trnkaja5/Meteostanice/README.md

# Meteostanice
Maturitni projekt

Cílem této práce je navrhnout a zkonstruovat
meteostanici s venkovní a vnitřní
jednotkou, která měří základní meteorologická
data a zpracovává je ve vnitřní
jednotce. Data se budou zapisovat na
microSD a zobrazovat na displeji a webserveru.
