trnkaja5/Meteostanice/elektro/dokumentace_DPS.pdf

Dokumentace DPS - Meteostanice | Jan Trnka 4EB
- Návrh všech plošných spojů jsem realizoval v programu KiCad 7.0.

## Vnitřní jednotka:

### Schéma:

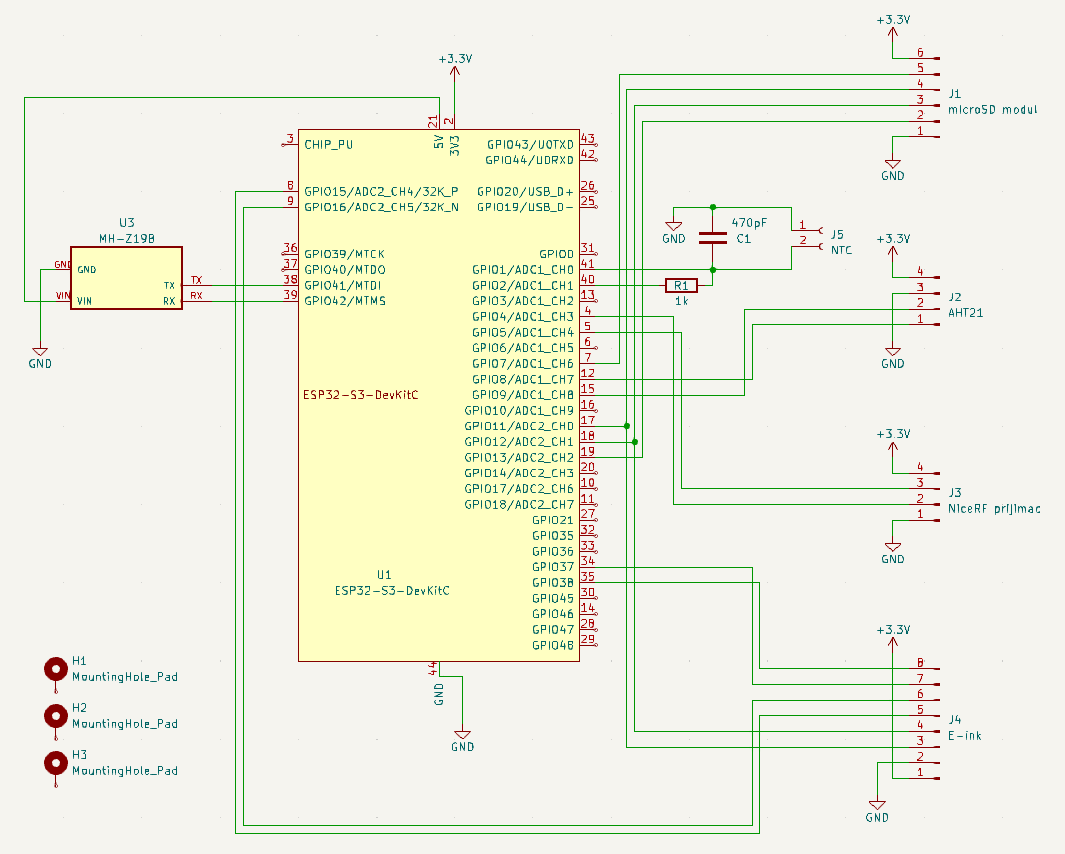
[picture p30: figure]

### Board:

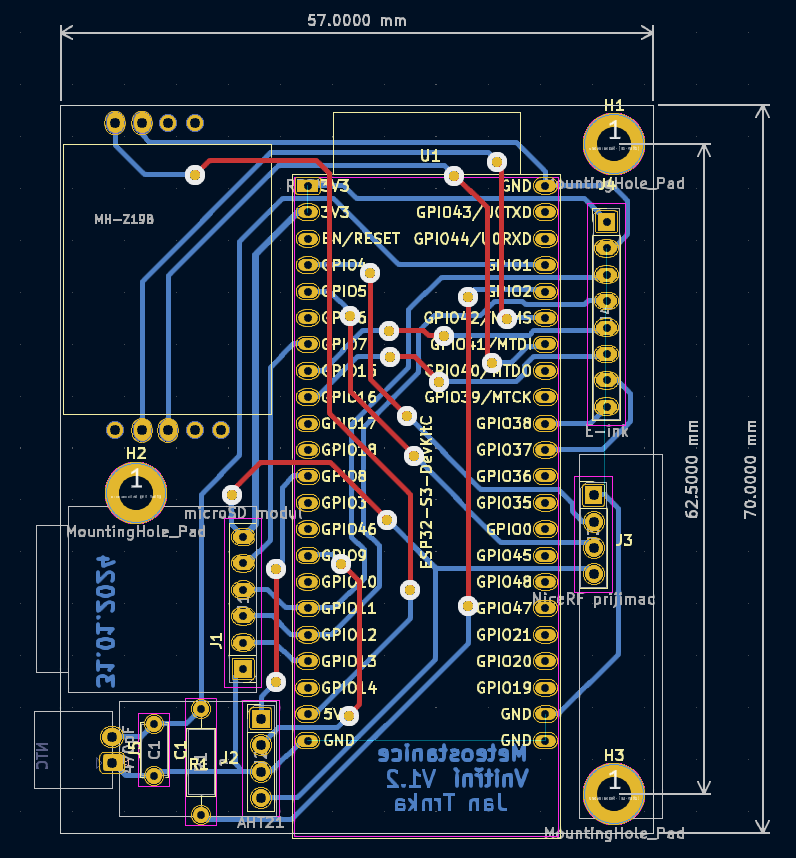
[picture p31: figure]

### Soubory pro leptání:

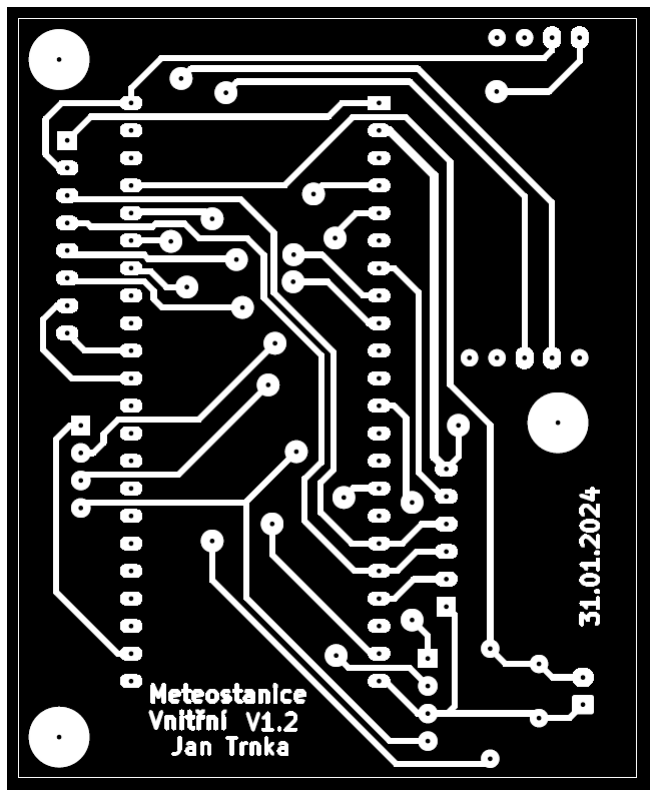
[picture p32: figure]

### Seznam součástek:

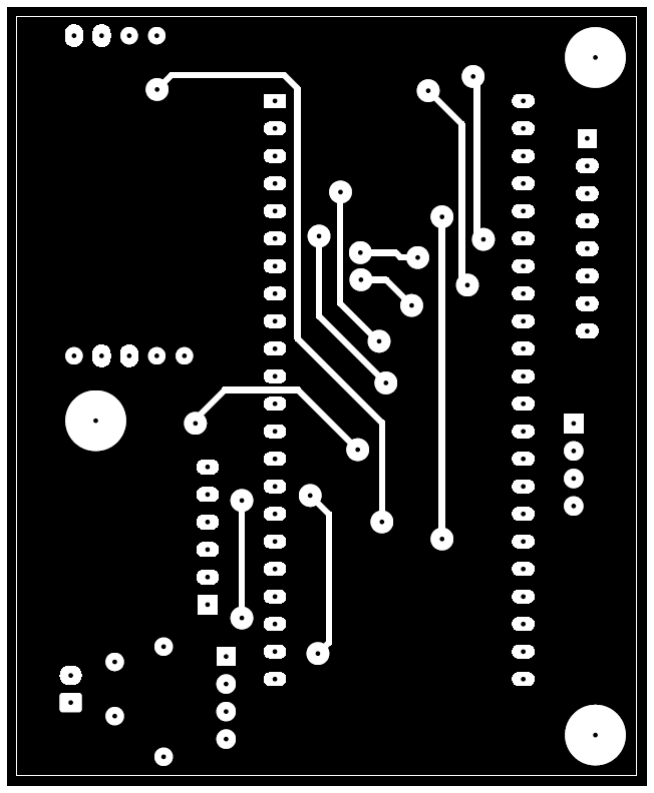
[picture p33: figure]

Esp32s3 DevKit | U1
MH-Z19B | U2
Konektor k NTC | J5
Kondenzátor 470pF | C1
Rezistor k NTC | R1
microSD modul | J1
AHT21 | J2
Rádiový přijímač | J3
Displej | J4
Bottom | Front

## Venkovní jednotka:

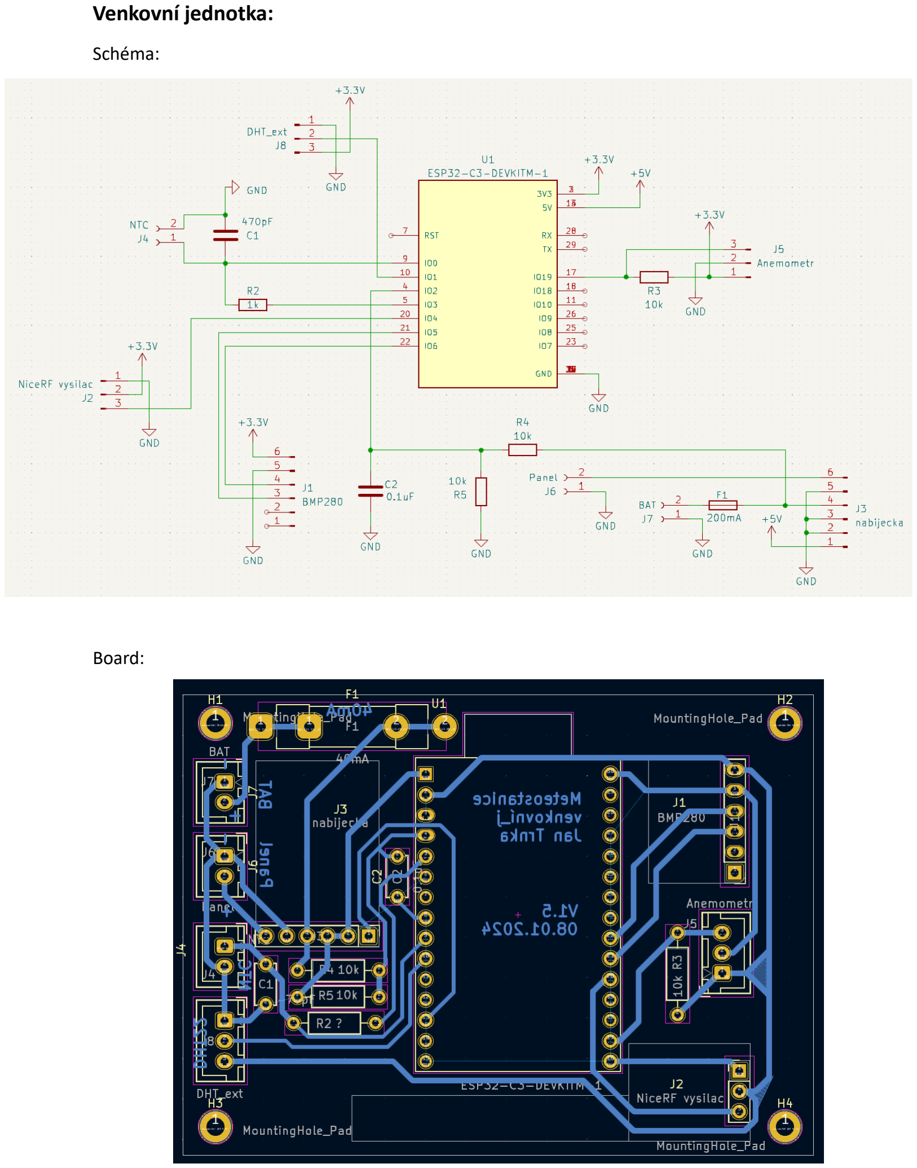
[picture p34: page 4]

### Schéma:

### Board:

### Soubor pro leptání:

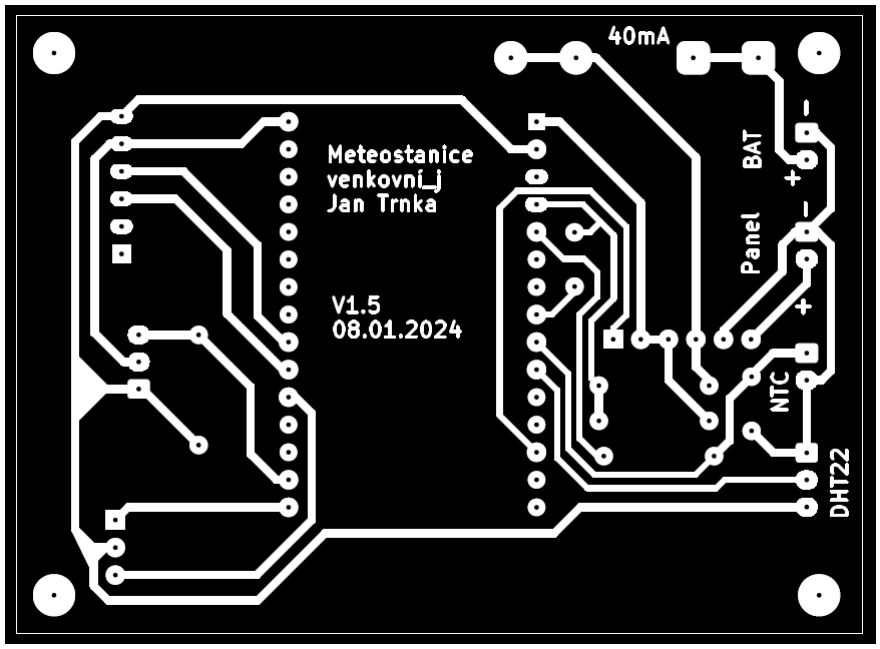
[picture p35: figure]

### Seznam součástek:

Esp32c3 DevKit | U1
DHT22 | U2
BMP280 | J1
Rádiový vysílač | J2
Solární nabíječka | J3
Konektor k NTC | J4
Kondenzátor 470pF | C1
Rezistor k DHT22 – 1kΩ | R1
Rezistor k NTC | R2
Pojistka trubičková 200 mA | F1

Bottom

## DPS pro senzor DHT22:

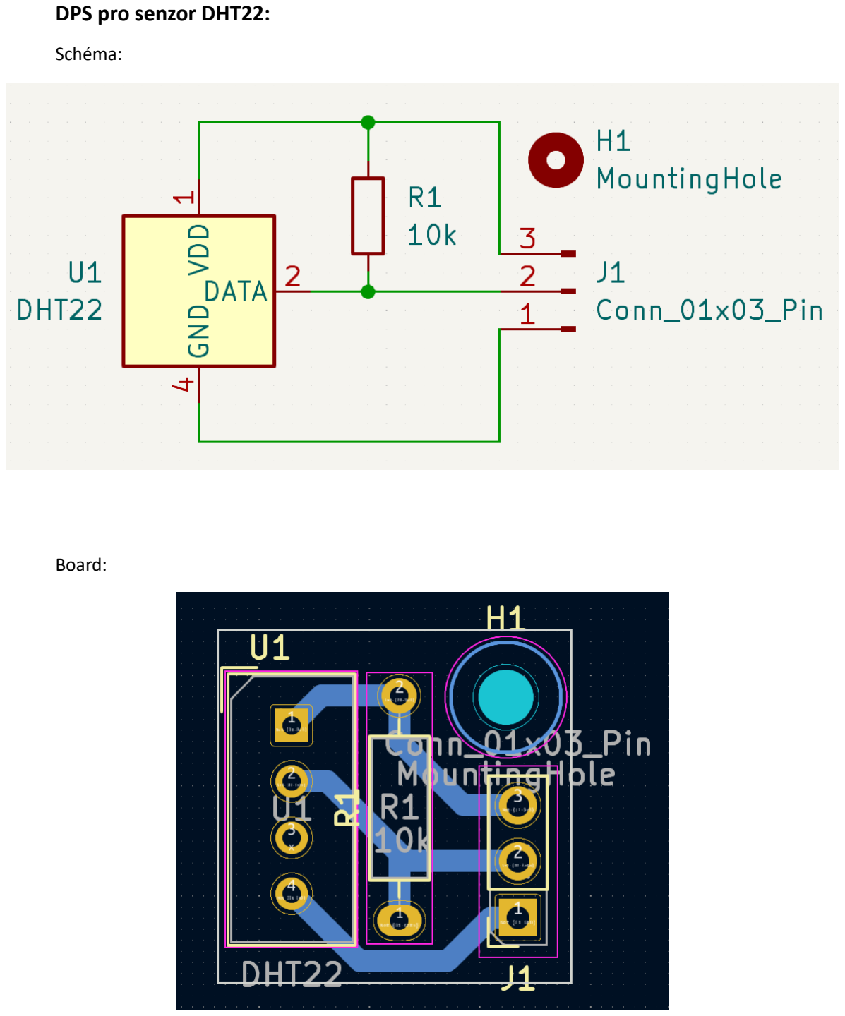
[picture p36: page 6]

### Schéma:

### Board:

### Soubor pro leptání:

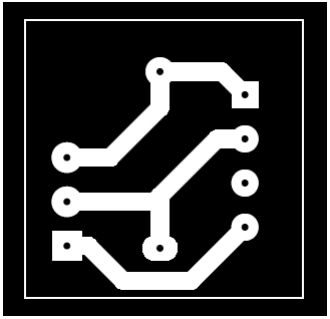
[picture p37: figure]

### Seznam součástek:

DHT22 | U1
Rezistor 1kΩ | R1

## Funkčnost:

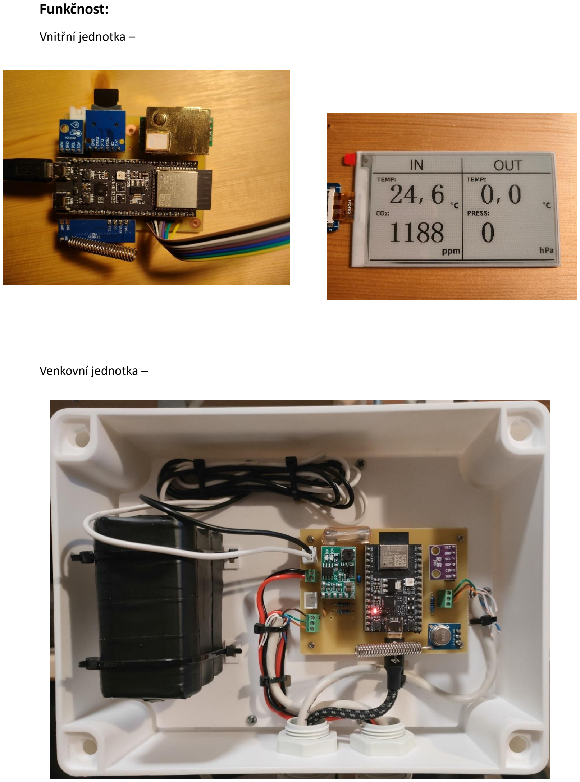
[picture p38: page 8]

### Vnitřní jednotka –

### Venkovní jednotka –

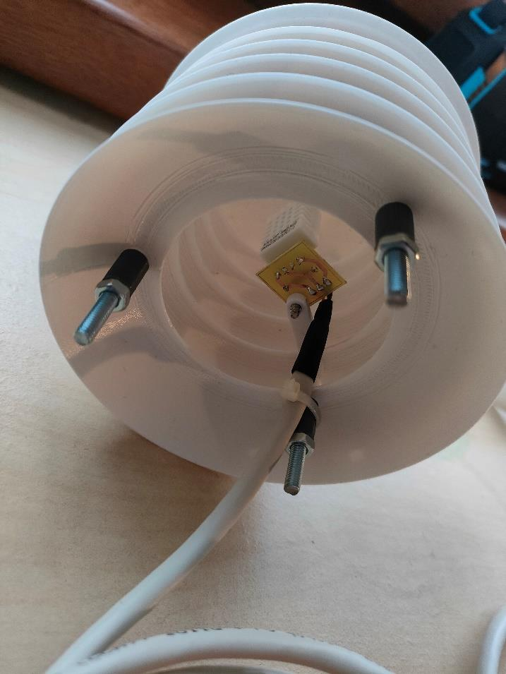
[picture p39: figure]

### DHT22:

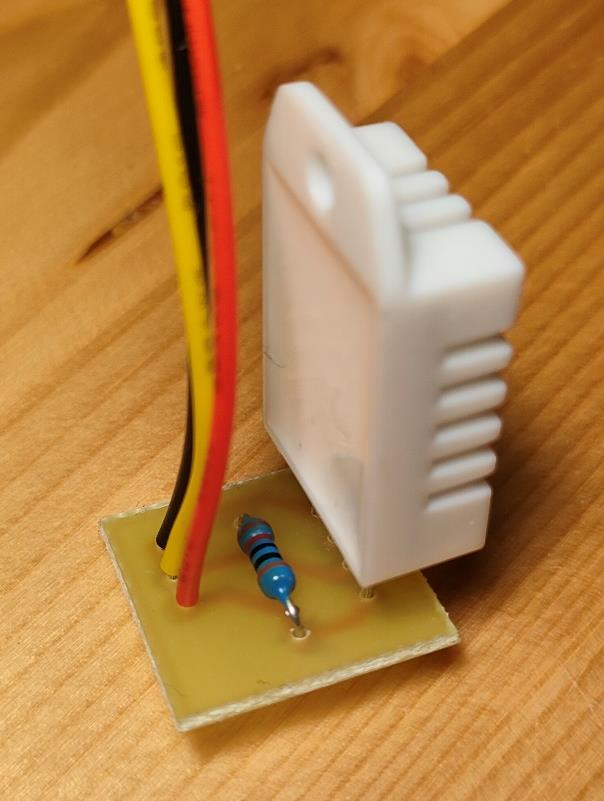
[picture p40: figure]
