trnkaja5/Meteostanice/elektro/schema_zapojeni_venkovni_jednotka.png

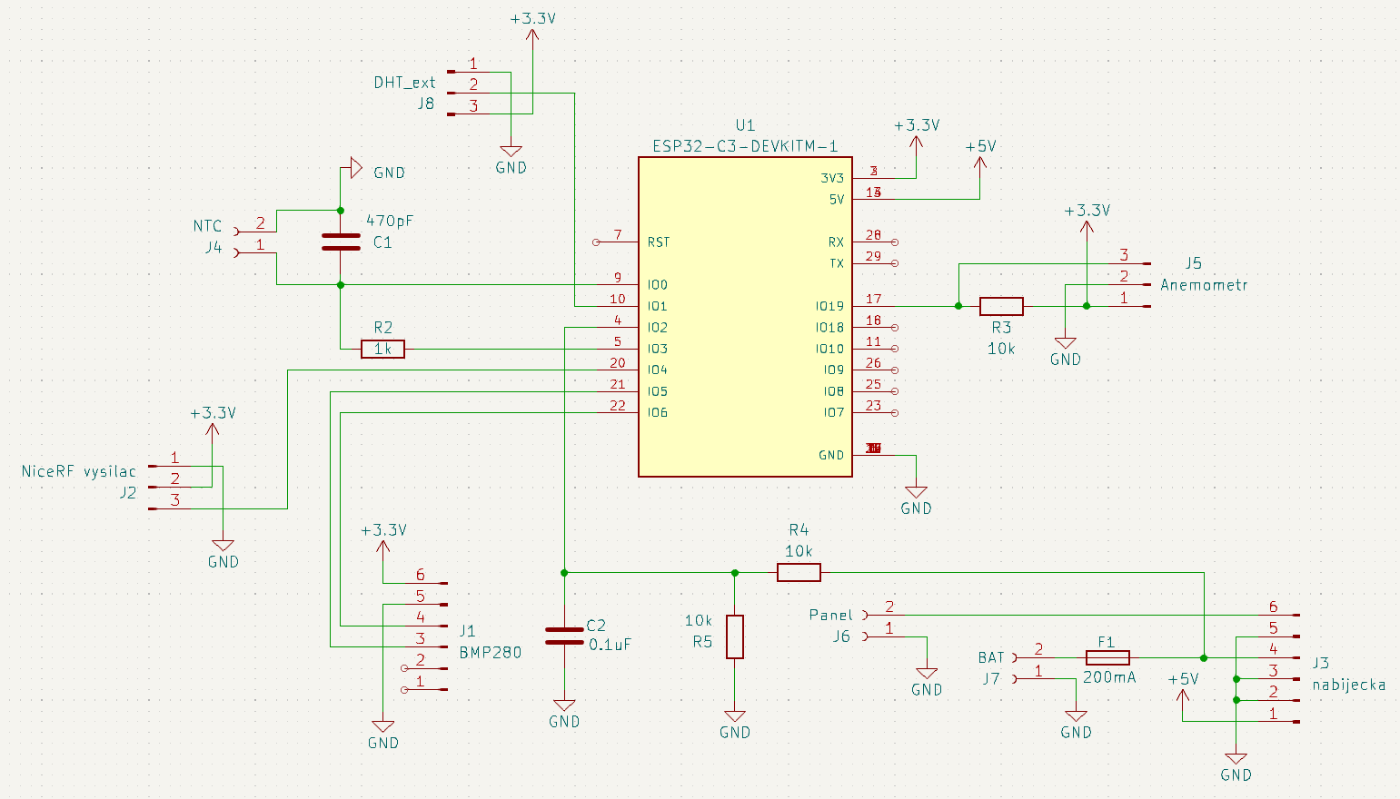
elektro/schema_zapojeni_venkovni_jednotka.png
