trnkaja5/Meteostanice/media/foto_venkovni_jednotka.jpg

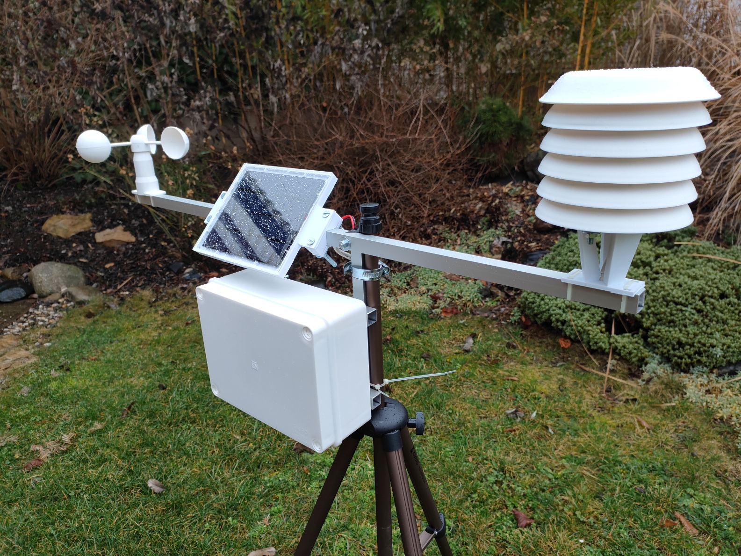
media/foto_venkovni_jednotka.jpg
