trnkaja5/Meteostanice/media/foto_vnitrni_jednotka.jpg

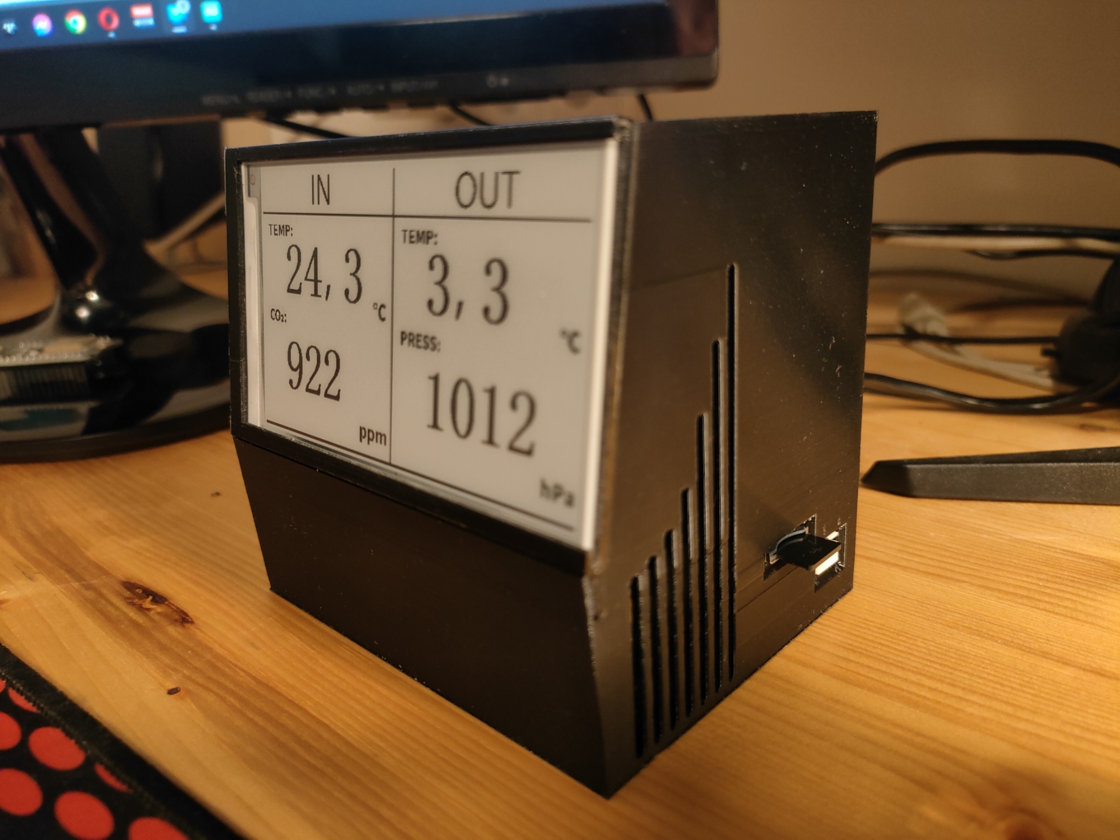
media/foto_vnitrni_jednotka.jpg
