trnkaja5/Meteostanice/media/foto_zapojeni_venkovni.jpg

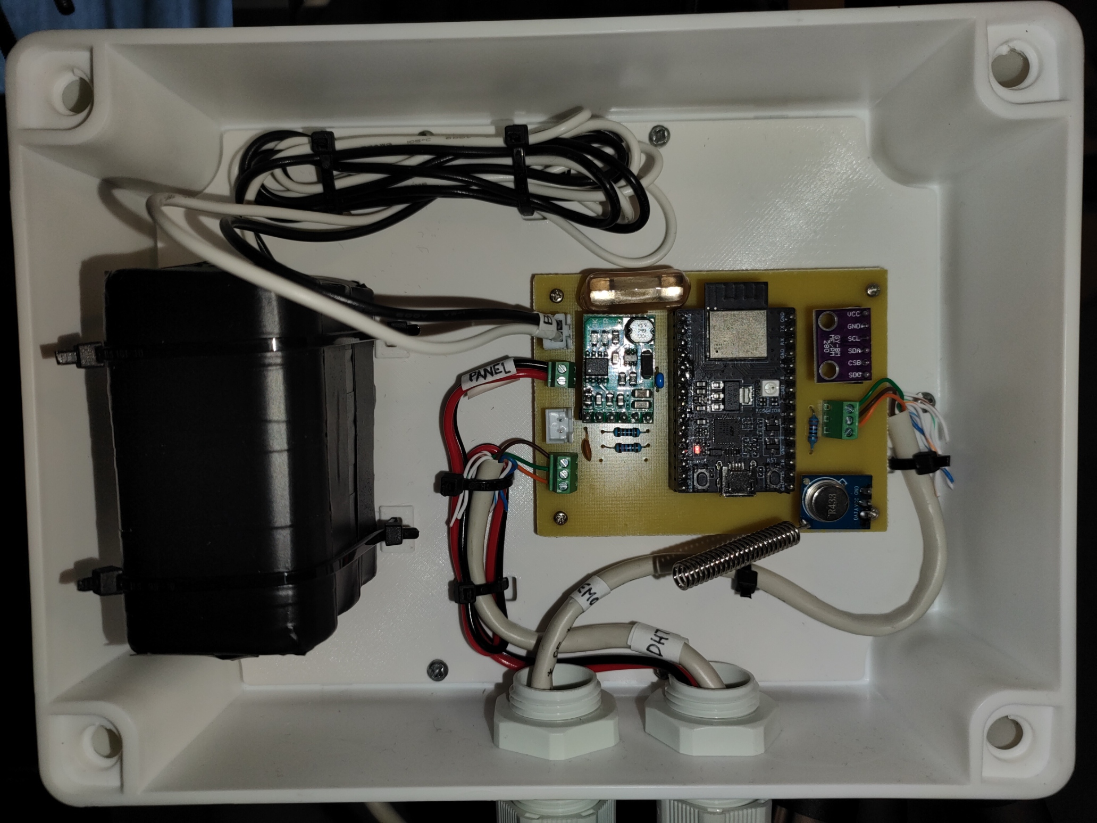
media/foto_zapojeni_venkovni.jpg
