trnkaja5/Meteostanice/media/foto_zapojeni_vnitrni.jpg

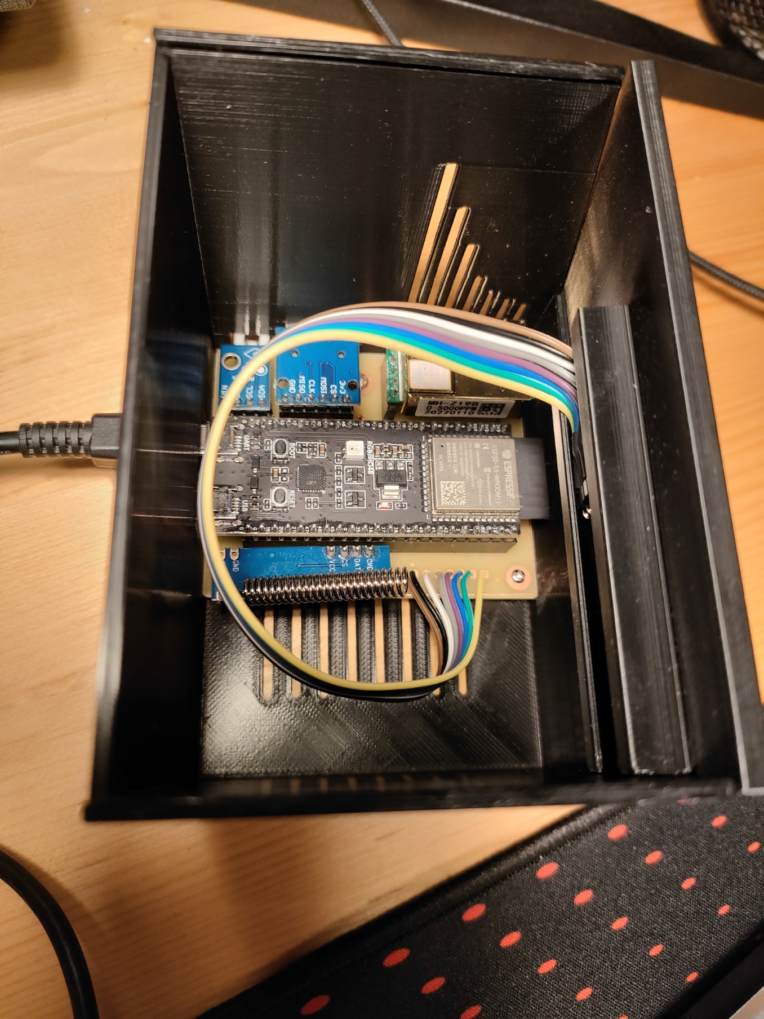
media/foto_zapojeni_vnitrni.jpg
