trnkaja5/Meteostanice/media/screenshot_webserver.png

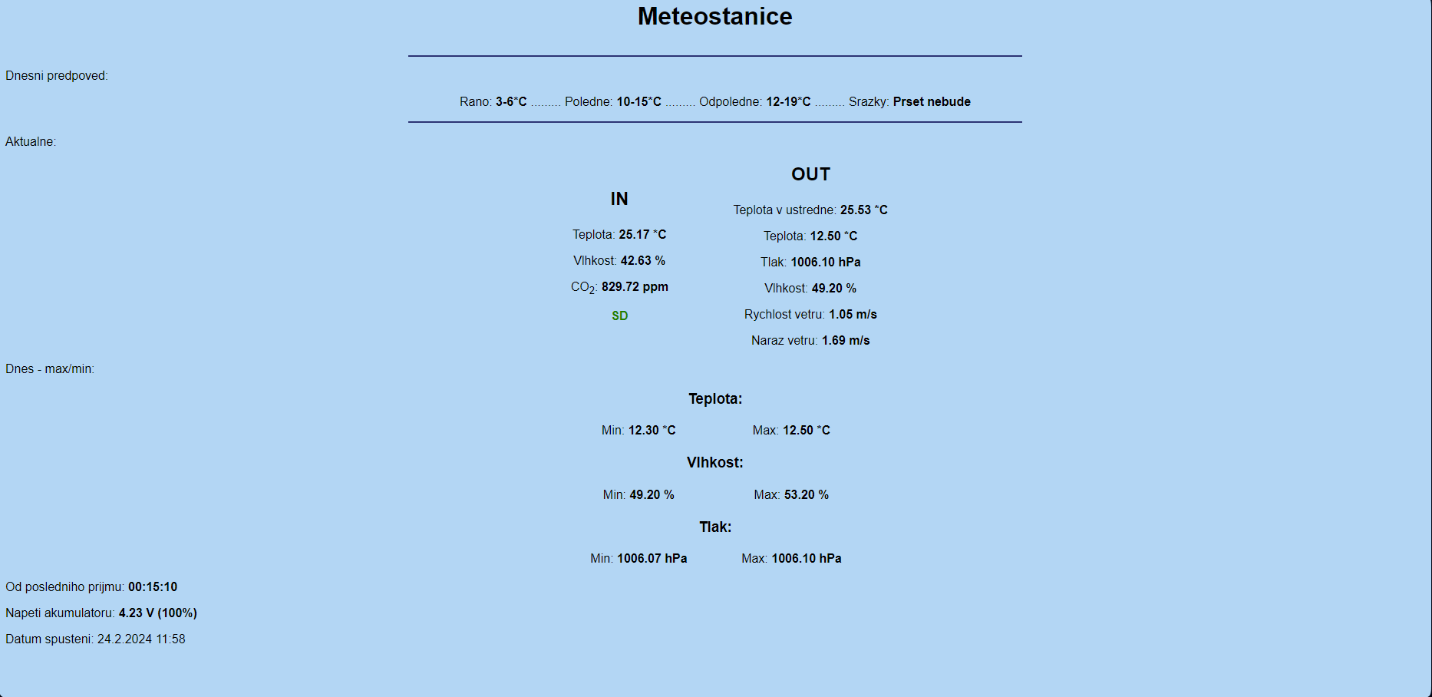
media/screenshot_webserver.png
