trnkaja5/Meteostanice/meteostanice_plakat.jpg

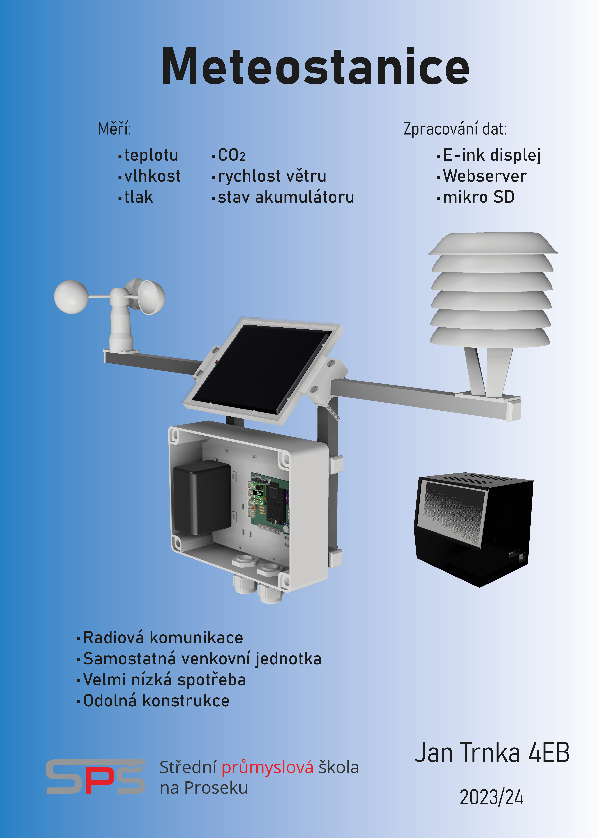
meteostanice_plakat.jpg
