trnkaja5/Meteostanice/elektro/KiCad_modely/DHT22 v1.step

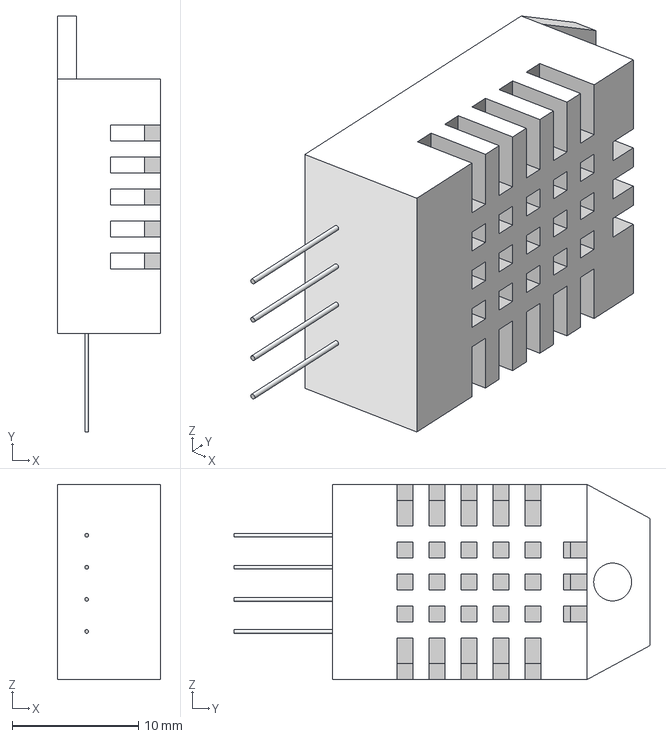
[picture p51: CAD file, 2024-11-08]
elektro/KiCad_modely/DHT22 v1.step
8.15 x 33.0 x 15.5 mm
