trnkaja5/Meteostanice/mechanika/modely/radiační kryt_uchyt v3.stl

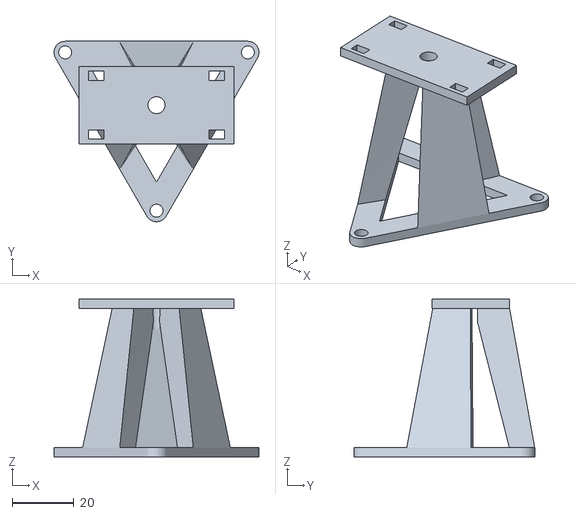
[picture p52: CAD file, 2024-11-08]
mechanika/modely/radiační kryt_uchyt v3.stl
66.2 x 58.3 x 51.0
