trnkaja5/Meteostanice/elektro/KiCad_modely/bmp280 v1.step

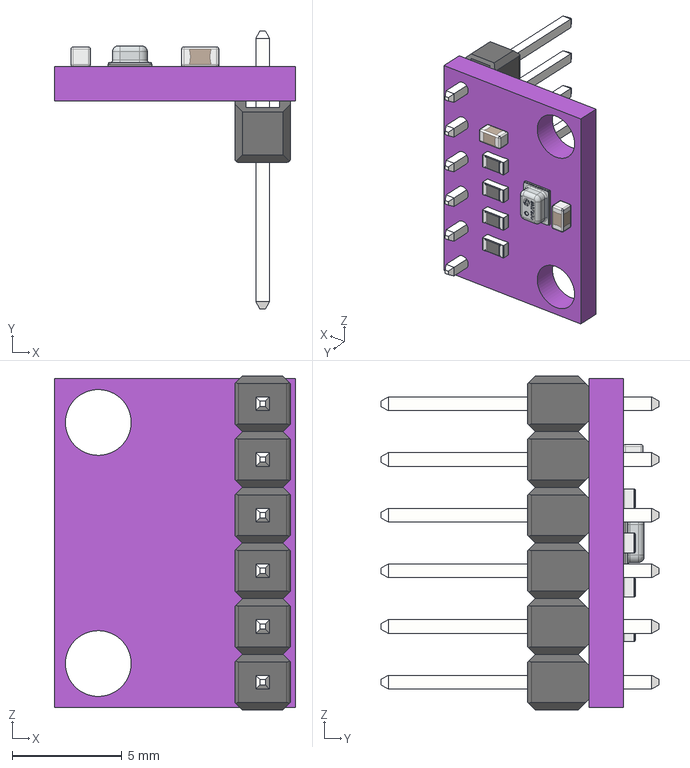
[picture p53: CAD file, 2024-11-08]
elektro/KiCad_modely/bmp280 v1.step
11.0 x 12.7 x 15.2 mm
