trnkaja5/Meteostanice/mechanika/modely/redukce do krabice v6.stl

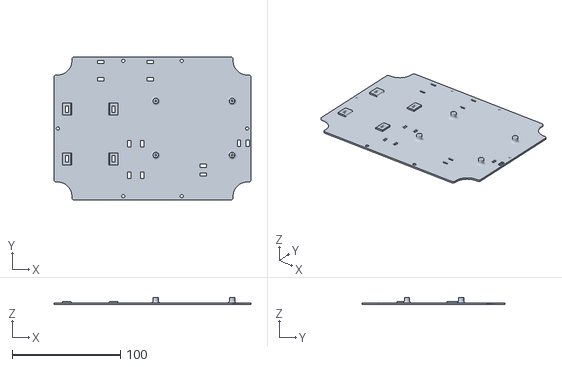
[picture p54: CAD file, 2024-11-08]
mechanika/modely/redukce do krabice v6.stl
182.0 x 132.0 x 6.50
