trnkaja5/Meteostanice/elektro/KiCad_modely/MH-Z19B v1.step

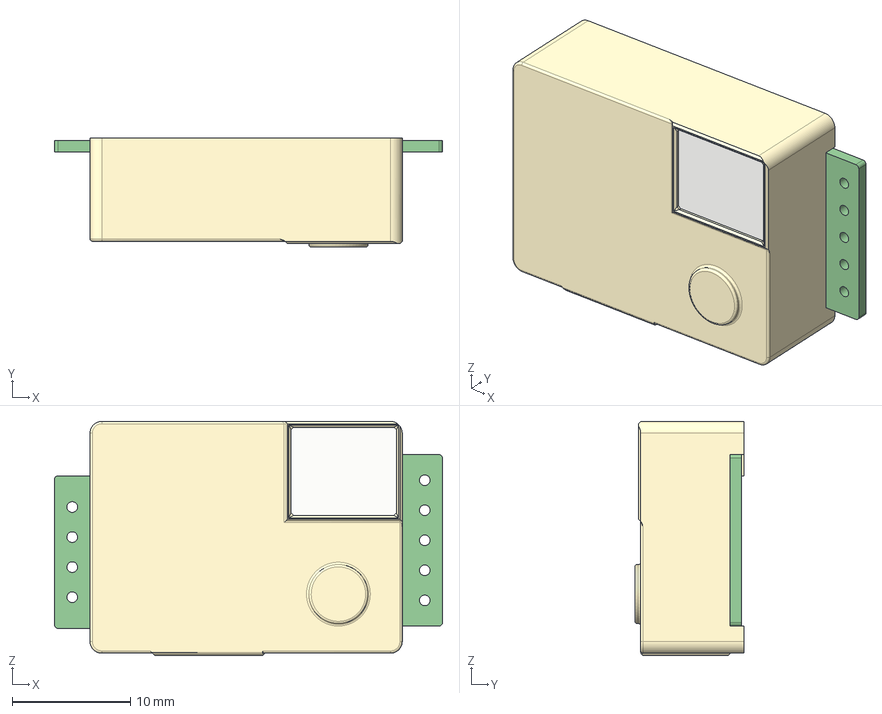
[picture p55: CAD file, 2024-11-08]
elektro/KiCad_modely/MH-Z19B v1.step
32.8 x 9.25 x 19.8 mm
