trnkaja5/Meteostanice/mechanika/modely/Sloupek(radiackniKryt) v3.stl

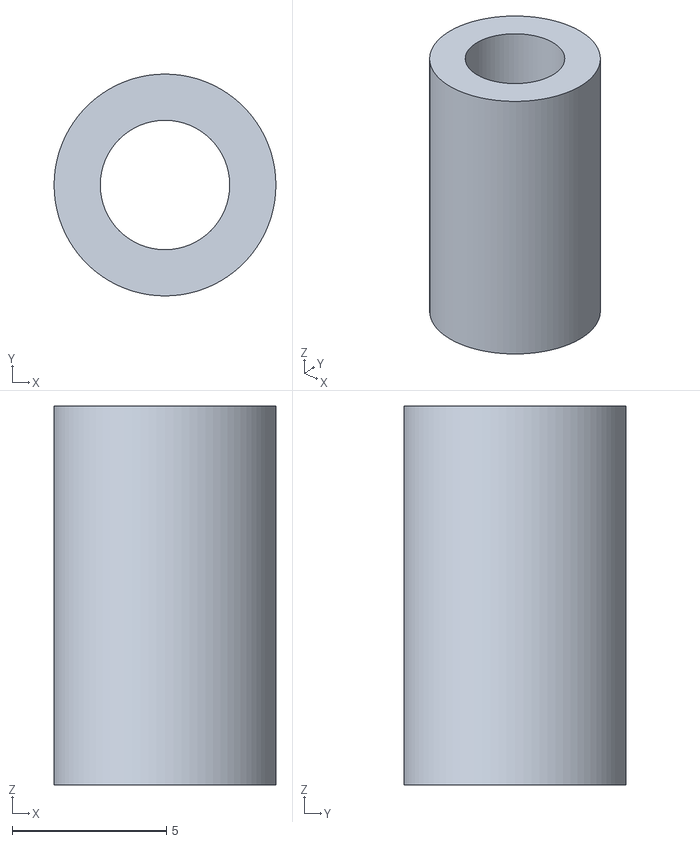
[picture p56: CAD file, 2024-11-08]
mechanika/modely/Sloupek(radiackniKryt) v3.stl
7.20 x 7.20 x 12.3
