trnkaja5/Meteostanice/elektro/KiCad_modely/POJISTKA v2.step

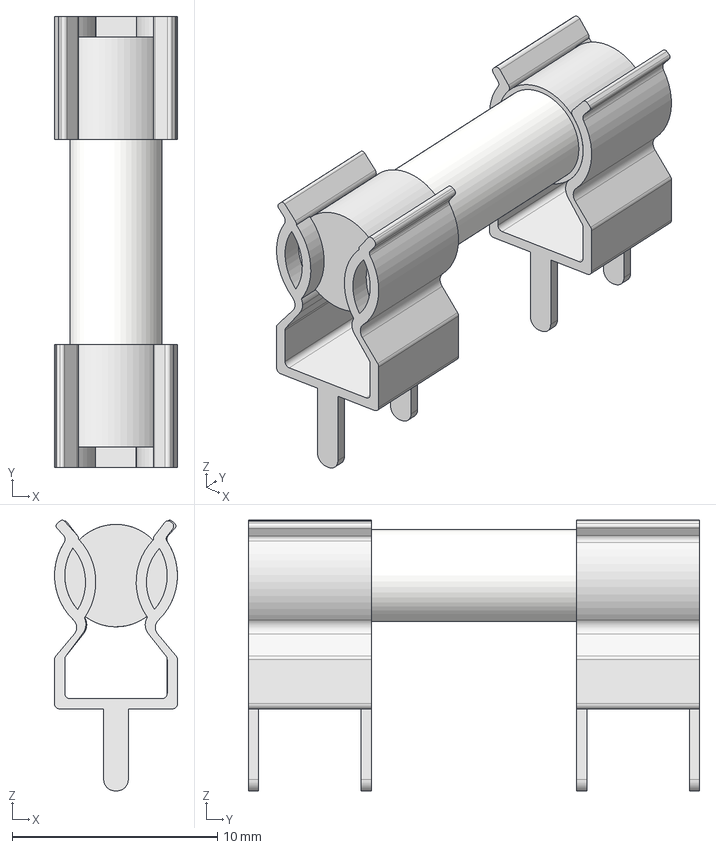
[picture p57: CAD file, 2024-11-08]
elektro/KiCad_modely/POJISTKA v2.step
6.00 x 22.0 x 13.2 mm
pojistka_1
drzak pojistky x 2
