trnkaja5/Meteostanice/mechanika/modely/krytka 15x15 v1.stl

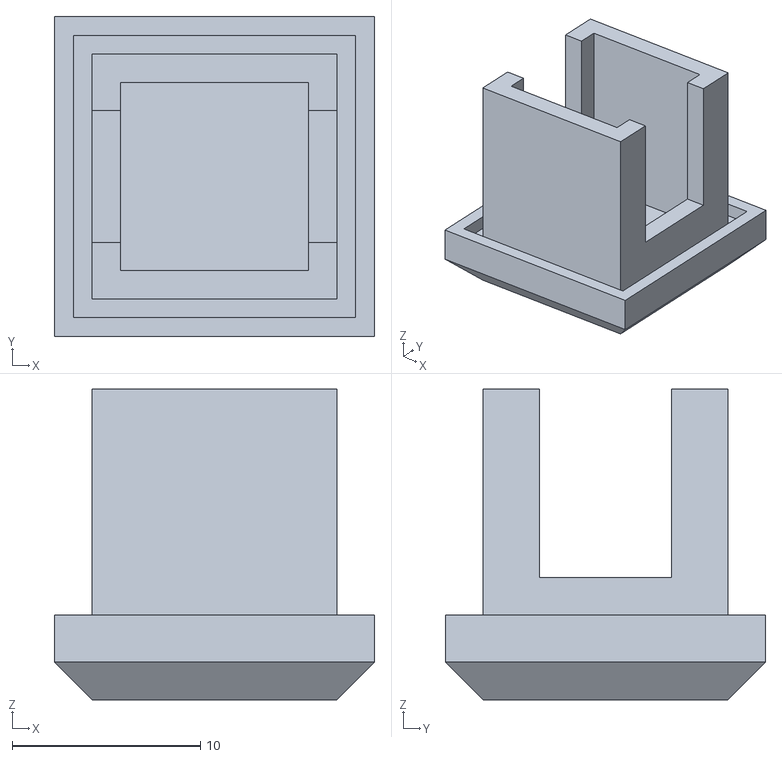
[picture p58: CAD file, 2024-11-08]
mechanika/modely/krytka 15x15 v1.stl
17.0 x 17.0 x 16.5
