trnkaja5/Meteostanice/elektro/KiCad_modely/solarni nabijecka v2.step

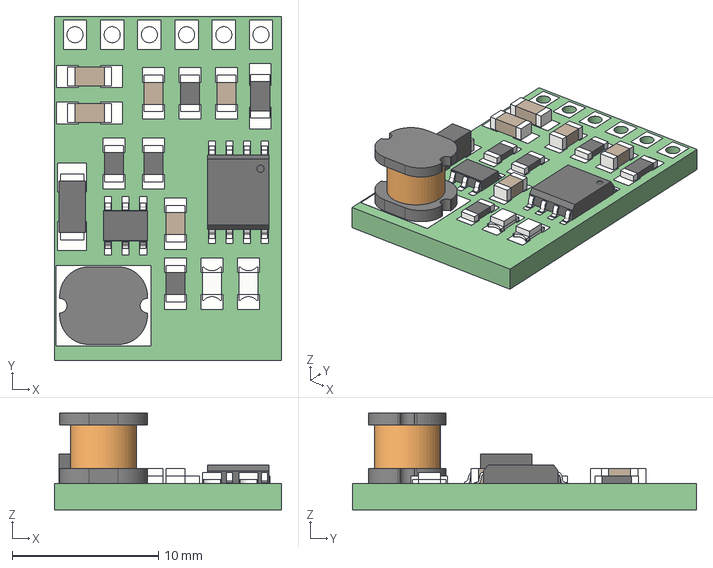
[picture p59: CAD file, 2024-11-08]
elektro/KiCad_modely/solarni nabijecka v2.step
15.5 x 23.5 x 6.61 mm
