trnkaja5/Meteostanice/mechanika/modely/meteostanice_vnitrni-uchytDisplej v6.stl

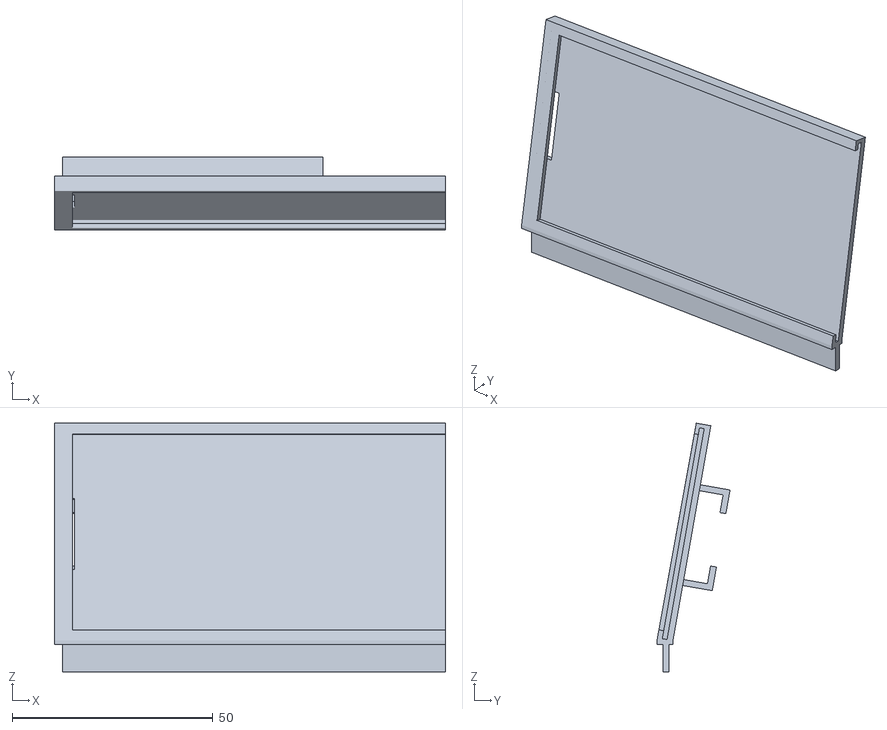
[picture p60: CAD file, 2024-11-08]
mechanika/modely/meteostanice_vnitrni-uchytDisplej v6.stl
97.5 x 18.2 x 62.0
