trnkaja5/Meteostanice/mechanika/modely/kryt na panel_uchyt1 v1.stl

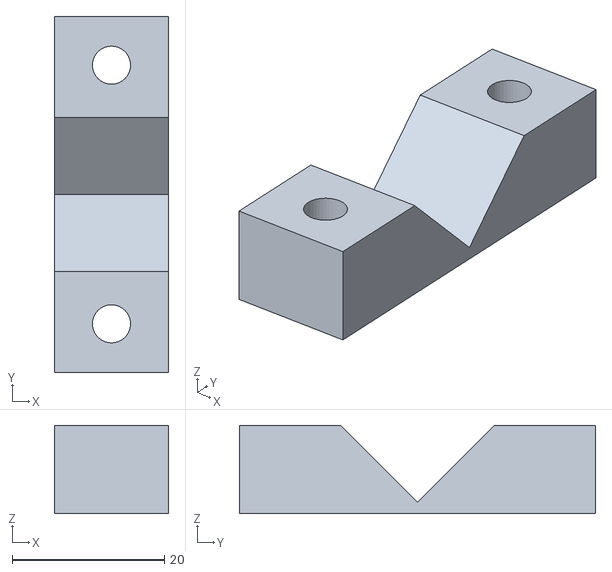
[picture p61: CAD file, 2024-11-08]
mechanika/modely/kryt na panel_uchyt1 v1.stl
15.0 x 46.8 x 11.6
