trnkaja5/Meteostanice/elektro/KiCad_modely/NiceRF_transmitter v3.step

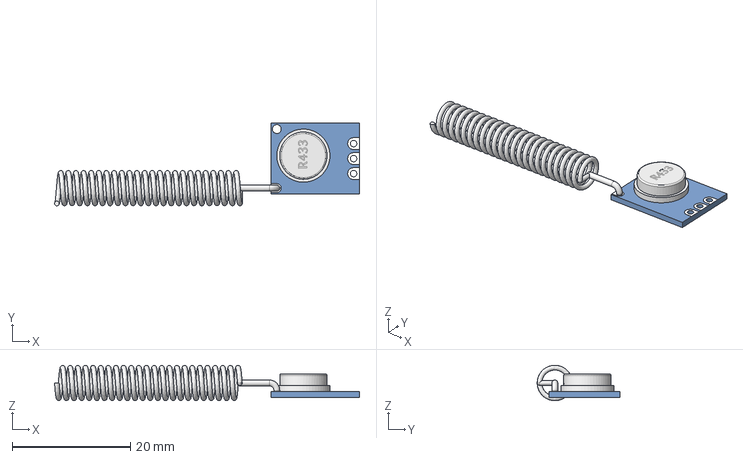
[picture p62: CAD file, 2024-11-08]
elektro/KiCad_modely/NiceRF_transmitter v3.step
51.6 x 14.0 x 6.00 mm
