trnkaja5/Meteostanice/mechanika/modely/Vrtule2_spodni cast v4.stl

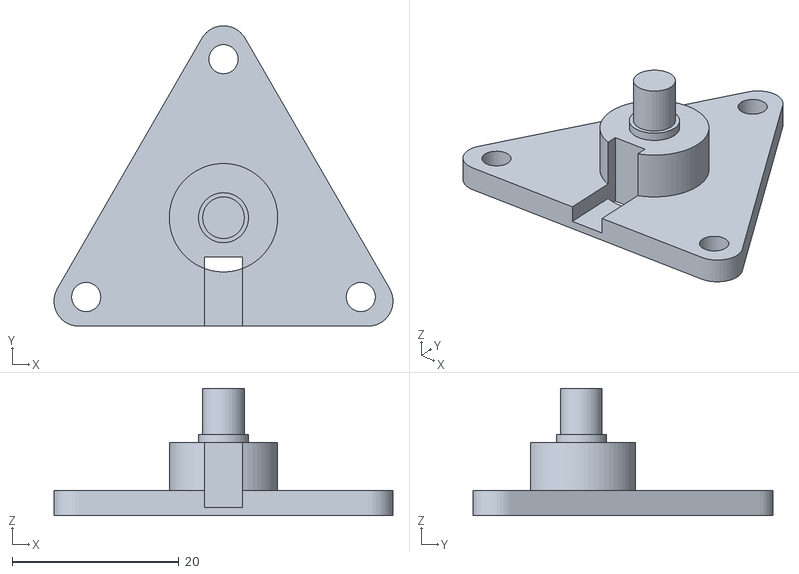
[picture p63: CAD file, 2024-11-08]
mechanika/modely/Vrtule2_spodni cast v4.stl
40.6 x 36.0 x 15.2
