trnkaja5/Meteostanice/mechanika/modely/radiační kryt vršek v3.stl

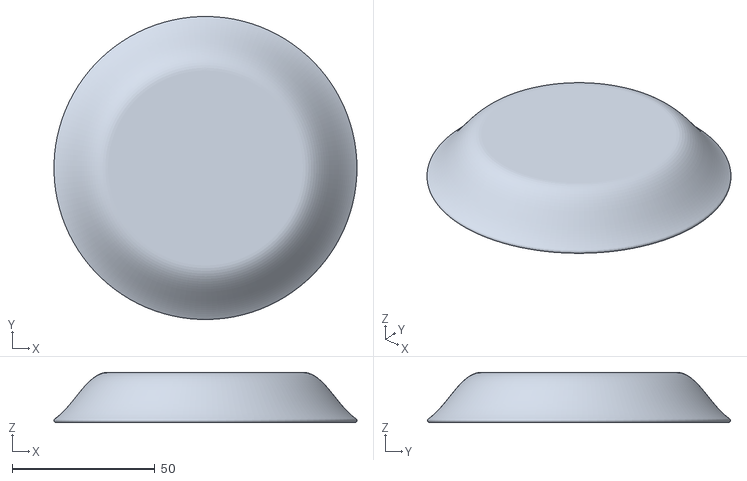
[picture p64: CAD file, 2024-11-08]
mechanika/modely/radiační kryt vršek v3.stl
106.0 x 106.0 x 17.6
