trnkaja5/Meteostanice/mechanika/modely/Anemometr_spodnidil v4.stl

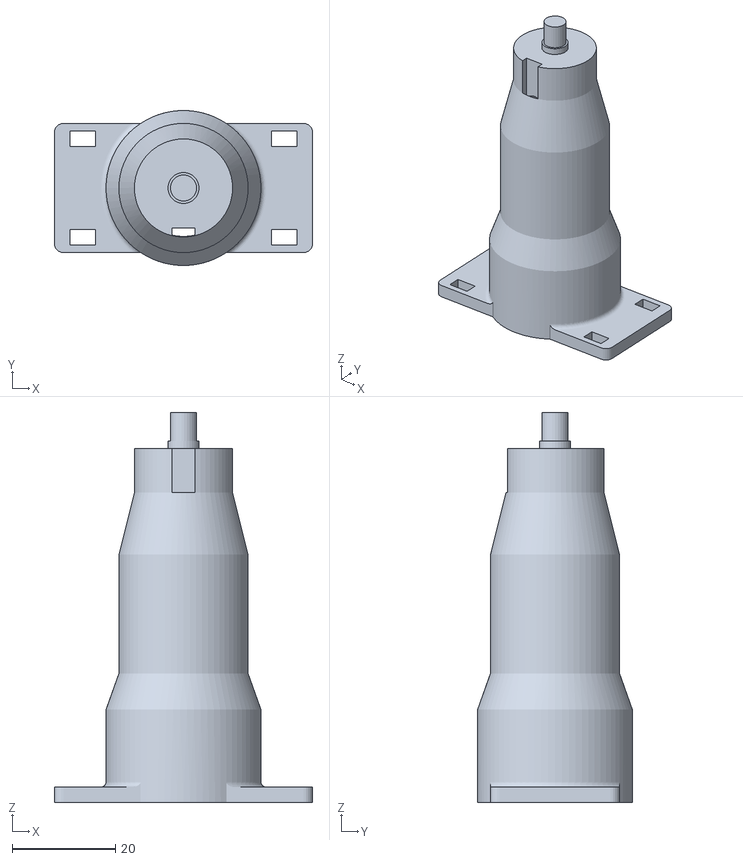
[picture p65: CAD file, 2024-11-08]
mechanika/modely/Anemometr_spodnidil v4.stl
50.0 x 30.0 x 75.5
