trnkaja5/Meteostanice/mechanika/modely/Anemometr v2.stl

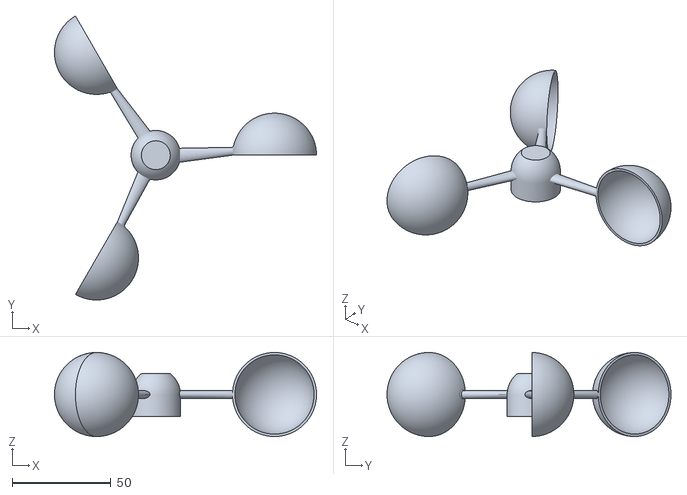
[picture p66: CAD file, 2024-11-08]
mechanika/modely/Anemometr v2.stl
132.5 x 143.6 x 42.5
