trnkaja5/Meteostanice/mechanika/modely/kryt na panel_uchyt2 v2.stl

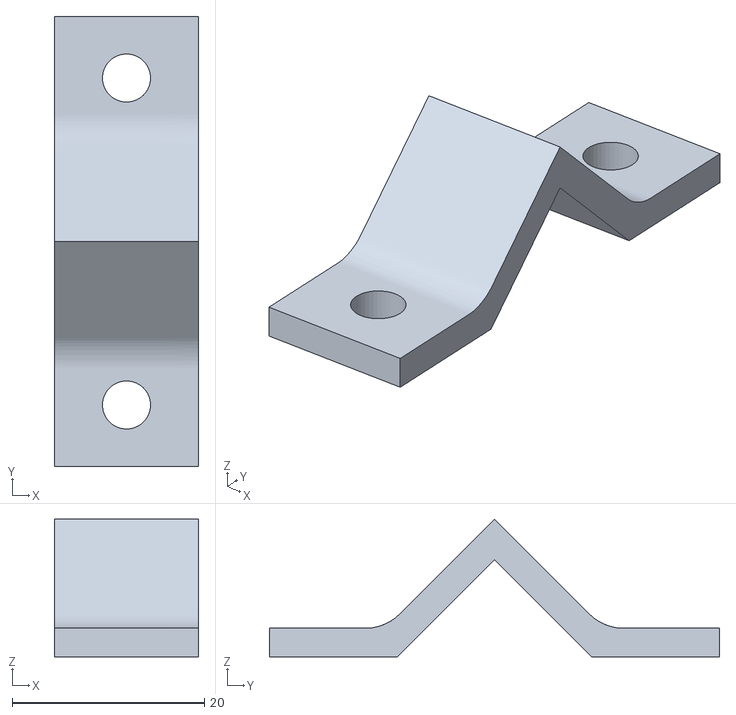
[picture p67: CAD file, 2024-11-08]
mechanika/modely/kryt na panel_uchyt2 v2.stl
15.0 x 46.8 x 14.3
