trnkaja5/Meteostanice/mechanika/modely/kryt na panel v5.stl

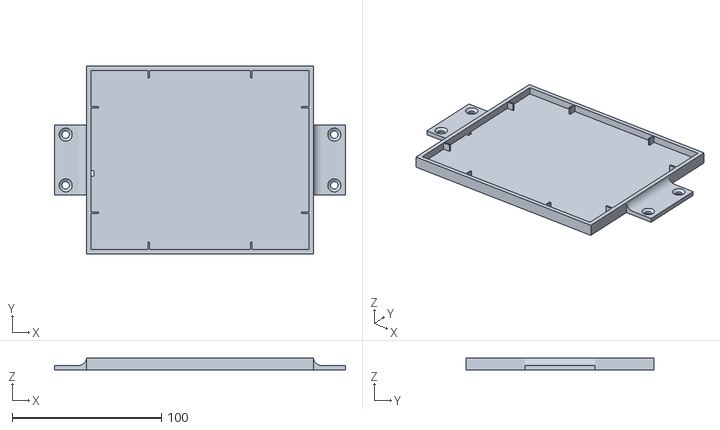
[picture p68: CAD file, 2024-11-08]
mechanika/modely/kryt na panel v5.stl
195.0 x 126.0 x 8.00
