trnkaja5/Meteostanice/mechanika/modely/uchyt na DHT v2.stl

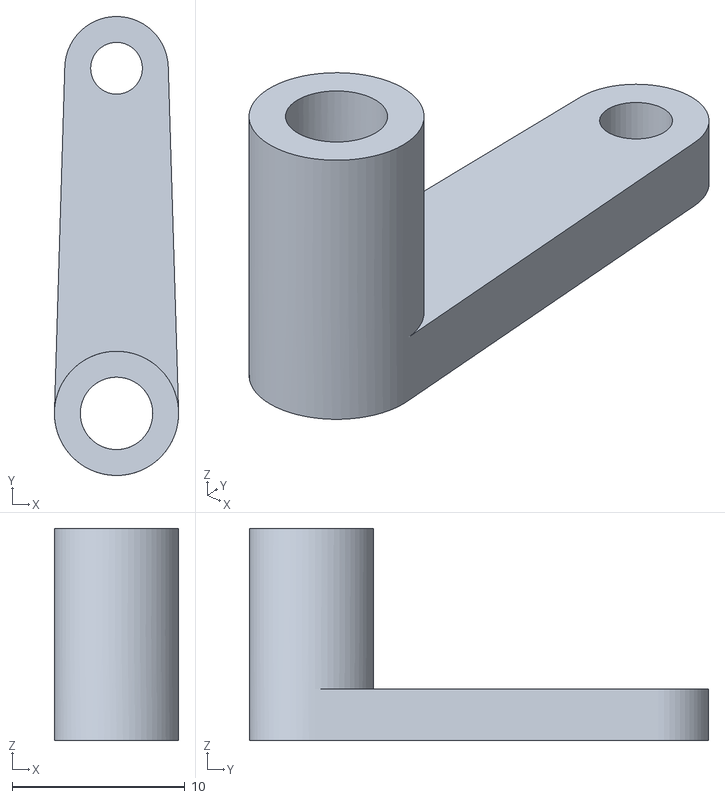
[picture p69: CAD file, 2024-11-08]
mechanika/modely/uchyt na DHT v2.stl
7.20 x 26.6 x 12.3
