trnkaja5/Meteostanice/mechanika/modely/Vrtule2_vrchni cast v5.stl

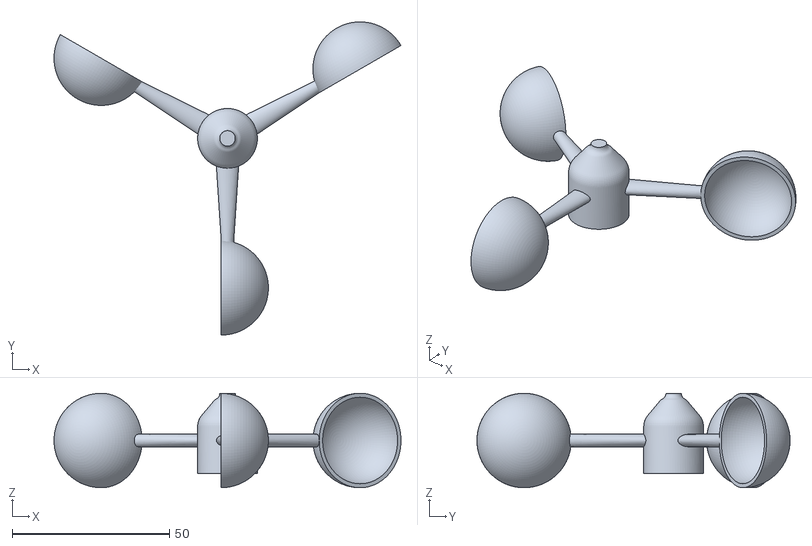
[picture p70: CAD file, 2024-11-08]
mechanika/modely/Vrtule2_vrchni cast v5.stl
110.3 x 99.5 x 30.0
