trnkaja5/Meteostanice/mechanika/modely/meteostanice_vnitrni-krabicka v10.stl

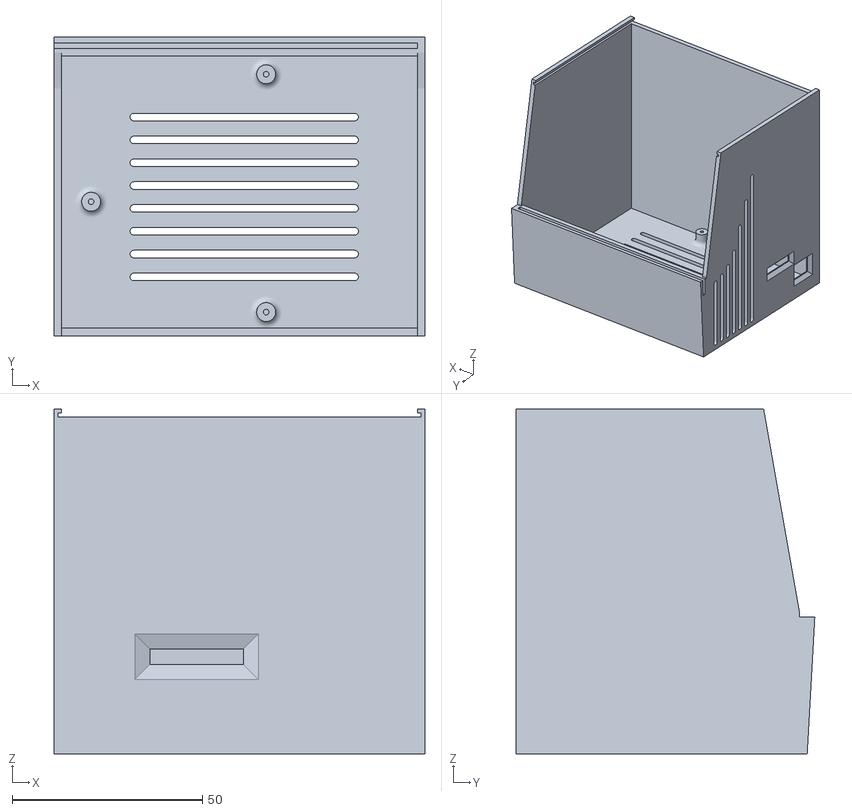
[picture p71: CAD file, 2024-11-08]
mechanika/modely/meteostanice_vnitrni-krabicka v10.stl
97.5 x 78.5 x 90.6
