trnkaja5/Meteostanice/mechanika/modely/radiační kryt v3.stl

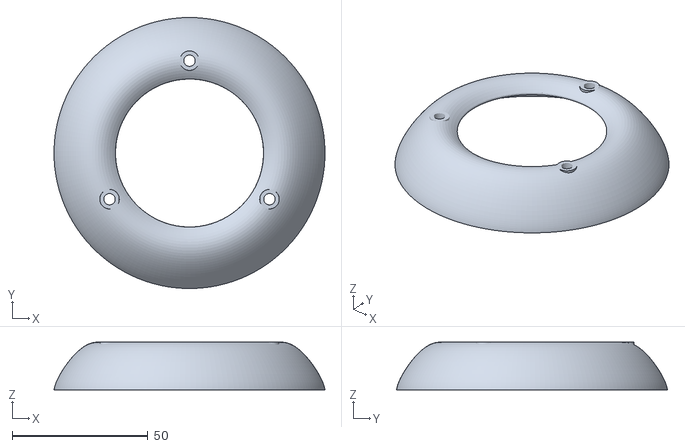
[picture p72: CAD file, 2024-11-08]
mechanika/modely/radiační kryt v3.stl
100.0 x 100.0 x 17.6
