trnkaja5/Meteostanice/mechanika/modely/meteostanice_vnitrni-viko v3.stl

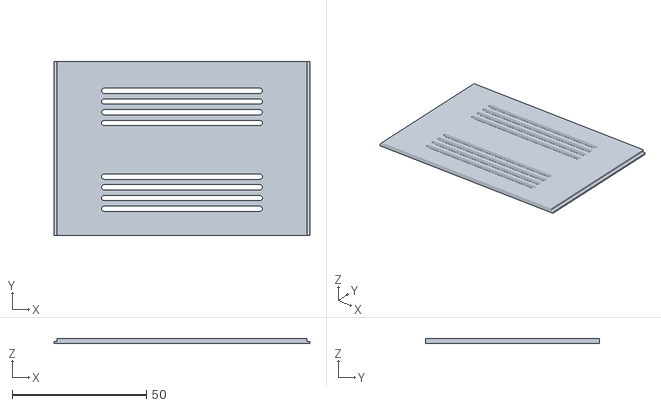
[picture p73: CAD file, 2024-11-08]
mechanika/modely/meteostanice_vnitrni-viko v3.stl
95.5 x 65.1 x 2.00
