trnkaja5/Meteostanice/(list of files, cad)

Other CAD files:
elektro/KiCad_modely/DHT22.SLDPRT
mechanika/ANEMOMETR SESTAVA v3.f3z
mechanika/METEOSTANICE VNITRNI SESTAVA v6.f3z
mechanika/Radiační kryt SESTAVA v9.f3z
