trnkaja5/Meteostanice/program/program_vnitrni_ESP32s3/Display_EPD_W21.cpp

  // Gooddisplay example codes -  https://www.good-display.com/companyfile/24/

#include "Display_EPD_W21_spi.h"
#include "Display_EPD_W21.h"

unsigned char oldData[12480];
unsigned char oldDataP[256];

unsigned char oldDataTIN1[256] { /* 0X01,0X01,0X20,0X00,0X40,0X00, */
0XFF,0XFF,0XFF,0XFF,0XFF,0XFF,0XFF,0XFF,0XFF,0XFF,0XFF,0XFF,0XFF,0XFF,0XFF,0XFF,
0XFF,0XFF,0XFF,0XFF,0XFF,0XFF,0XFF,0XFF,0XFF,0XFF,0XFF,0XFF,0XFF,0XFF,0XFF,0XFF,
0XFF,0XFF,0XFF,0XFF,0XFF,0XFF,0XFF,0XFF,0XFF,0XFF,0XFF,0XFF,0XFF,0XFF,0XFF,0XFF,
0XFF,0XFF,0XFF,0XFF,0XFF,0XFF,0XFF,0XFF,0XFF,0XFF,0XFF,0XFF,0XFF,0XFF,0XFF,0XFF,
0XFF,0XFF,0XFF,0XFF,0XFF,0XFF,0XFF,0XFF,0XFF,0XFF,0XFF,0XFF,0XFF,0XFF,0XFF,0XFF,
0XFF,0XFF,0XFF,0XFF,0XFF,0XFF,0XFF,0XFF,0XFF,0XFF,0XFF,0XFF,0XFF,0XFF,0XFF,0XFF,
0XFF,0XFF,0XFF,0XFF,0XFF,0XFF,0XFF,0XFF,0XFF,0XFF,0XFF,0XFF,0XFF,0XFF,0XFF,0XFF,
0XFF,0XFF,0XFF,0XFF,0XFF,0XFF,0XFF,0XFF,0XFF,0XFF,0XFF,0XFF,0XFF,0XFF,0XFF,0XFF,
0XFF,0XFF,0XFF,0XFF,0XFF,0XFF,0XFF,0XFF,0XFF,0XFF,0XFF,0XFF,0XFF,0XFF,0XFF,0XFF,
0XFF,0XFF,0XFF,0XFF,0XFF,0XFF,0XFF,0XFF,0XFF,0XFF,0XFF,0XFF,0XFF,0XFF,0XFF,0XFF,
0XFF,0XFF,0XFF,0XFF,0XFF,0XFF,0XFF,0XFF,0XFF,0XFF,0XFF,0XFF,0XFF,0XFF,0XFF,0XFF,
0XFF,0XFF,0XFF,0XFF,0XFF,0XFF,0XFF,0XFF,0XFF,0XFF,0XFF,0XFF,0XFF,0XFF,0XFF,0XFF,
0XFF,0XFF,0XFF,0XFF,0XFF,0XFF,0XFF,0XFF,0XFF,0XFF,0XFF,0XFF,0XFF,0XFF,0XFF,0XFF,
0XFF,0XFF,0XFF,0XFF,0XFF,0XFF,0XFF,0XFF,0XFF,0XFF,0XFF,0XFF,0XFF,0XFF,0XFF,0XFF,
0XFF,0XFF,0XFF,0XFF,0XFF,0XFF,0XFF,0XFF,0XFF,0XFF,0XFF,0XFF,0XFF,0XFF,0XFF,0XFF,
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
0XFF,0XFF,0XFF,0XFF,0XFF,0XFF,0XFF,0XFF,0XFF,0XFF,0XFF,0XFF,0XFF,0XFF,0XFF,0XFF,
};

unsigned char oldDataA[256];
unsigned char oldDataB[256];
unsigned char oldDataC[256];
unsigned char oldDataD[256];
unsigned char oldDataE[256];
unsigned char partFlag=1;

bool lcd_status = 1;

void lcd_chkstatus(void)
{
  int timer = millis();
  while(!isEPD_W21_BUSY) { //0:BUSY, 1:FREE
    if(millis() - timer >= 1000) {
      lcd_status = 0;
      break;
    }
  }
}

//UC8253
void EPD_Init(void)
{ 
  EPD_W21_RST_0;    // Module reset
  delay(10);//At least 10ms delay 
  EPD_W21_RST_1;
  delay(10);//At least 10ms delay 
  
  EPD_W21_WriteCMD(0x04);  //Power on
  lcd_chkstatus();        //waiting for the electronic paper IC to release the idle signal

  EPD_W21_WriteCMD(0X50);  //VCOM AND DATA INTERVAL SETTING     
  EPD_W21_WriteDATA(0x97); //WBmode:VBDF 17|D7 VBDW 97 VBDB 57    WBRmode:VBDF F7 VBDW 77 VBDB 37  VBDR B7  
  
}
void EPD_Init_Fast(void) //1.0s
{ 
  EPD_W21_RST_0;    // Module reset
  delay(10);//At least 10ms delay 
  EPD_W21_RST_1;
  delay(10);//At least 10ms delay 
  
  EPD_W21_WriteCMD(0x04);  //Power on
  lcd_chkstatus();        //waiting for the electronic paper IC to release the idle signal

  EPD_W21_WriteCMD(0xE0);
  EPD_W21_WriteDATA(0x02); 

  EPD_W21_WriteCMD(0xE5);
  EPD_W21_WriteDATA(0x5F);  //0x5A--1.5s, 0x5F--1s

} 
void EPD_init_Fast2(void) //1.5s
{ 
  EPD_W21_RST_0;    // Module reset
  delay(10);//At least 10ms delay 
  EPD_W21_RST_1;
  delay(10);//At least 10ms delay 

  
  EPD_W21_WriteCMD(0x04);  //Power on
  lcd_chkstatus();        //waiting for the electronic paper IC to release the idle signal

  EPD_W21_WriteCMD(0xE0);
  EPD_W21_WriteDATA(0x02); 

  EPD_W21_WriteCMD(0xE5);
  EPD_W21_WriteDATA(0x5A);  //0x5A--1.5s, 0x5F--1s
  
} 
void EPD_Init_Part(void)
{ 
  EPD_W21_RST_0;    // Module reset
  delay(10);//At least 10ms delay 
  EPD_W21_RST_1;
  delay(10);//At least 10ms delay 
    
  EPD_W21_WriteCMD(0x04);  //Power on
  lcd_chkstatus();        //waiting for the electronic paper IC to release the idle signal

  EPD_W21_WriteCMD(0xE0);
  EPD_W21_WriteDATA(0x02); 

  EPD_W21_WriteCMD(0xE5);
  EPD_W21_WriteDATA(0x6E);
    
  EPD_W21_WriteCMD(0x50); 
  EPD_W21_WriteDATA(0xD7); 
  
} 
void EPD_DeepSleep(void)
{
  EPD_W21_WriteCMD(0X02);   //power off
  lcd_chkstatus();          //waiting for the electronic paper IC to release the idle signal
  delay(100);//At least 100ms delay 
  EPD_W21_WriteCMD(0X07);   //deep sleep
  EPD_W21_WriteDATA(0xA5); 
  
}
void Power_off(void)
{ 
  EPD_W21_WriteCMD(0x02); //POWER ON
  lcd_chkstatus();
}
//Full screen refresh update function
void EPD_Update(void)
{   
  //Refresh
  EPD_W21_WriteCMD(0x12);   //DISPLAY REFRESH   
  delay(1);              //!!!The delay here is necessary, 200uS at least!!!     
  lcd_chkstatus();          //waiting for the electronic paper IC to release the idle signal
}
void EPD_WhiteScreen_ALL(const unsigned char *datas)
{
    unsigned int i;
    //Write Data
    EPD_W21_WriteCMD(0x10);        //Transfer old data
    for(i=0;i<EPD_ARRAY;i++)    
    { 
       EPD_W21_WriteDATA(oldData[i]);  //Transfer the actual displayed data
    } 
    EPD_W21_WriteCMD(0x13);        //Transfer new data
    for(i=0;i<EPD_ARRAY;i++)       
    {
      EPD_W21_WriteDATA(datas[i]);  //Transfer the actual displayed data
       oldData[i]=datas[i]; 
    }   
    EPD_Update();    
    Power_off();
}

//Clear screen display
void EPD_WhiteScreen_White(void)
{
    unsigned int i;
    //Write Data
    EPD_W21_WriteCMD(0x10);      
    for(i=0;i<EPD_ARRAY;i++)       
    {
      EPD_W21_WriteDATA(oldData[i]);  
    }
    EPD_W21_WriteCMD(0x13);      
    for(i=0;i<EPD_ARRAY;i++)       
    {
      EPD_W21_WriteDATA(0xff);  
      oldData[i]=0xff; 
    }
    EPD_Update();    
    Power_off();
}
//Display all black
void EPD_WhiteScreen_Black(void)
{
    unsigned int i;
    //Write Data
    EPD_W21_WriteCMD(0x10);      
    for(i=0;i<EPD_ARRAY;i++)       
    {
      EPD_W21_WriteDATA(oldData[i]);  
    }
    EPD_W21_WriteCMD(0x13);      
    for(i=0;i<EPD_ARRAY;i++)       
    {
      EPD_W21_WriteDATA(0x00);  
      oldData[i]=0x00; 
    }
    EPD_Update();    
    Power_off();
}
//Partial refresh of background display, this function is necessary, please do not delete it!!!
void EPD_SetRAMValue_BaseMap( const unsigned char * datas)
{
  unsigned int i; 
  EPD_W21_WriteCMD(0x10);  //write old data 
  for(i=0;i<EPD_ARRAY;i++)
   {               
     EPD_W21_WriteDATA(oldData[i]);
   }
  EPD_W21_WriteCMD(0x13);  //write new data 
  for(i=0;i<EPD_ARRAY;i++)
   {               
     EPD_W21_WriteDATA(datas[i]);
      oldData[i]=datas[i]; 
   }   
    EPD_Update();    
    Power_off();   
   
}
//////////////////////////////////////////////////////////////////////////////////////////////////////////////////////////////////////////
void EPD_Dis_Part(unsigned int y_start,unsigned int x_start,const unsigned char * datas,unsigned int PART_COLUMN,unsigned int PART_LINE, int j)
{
unsigned int i;
unsigned int x_end,y_end; 
  x_start=x_start-x_start%8;
  x_end=x_start+PART_LINE-1; 
  y_end=y_start+PART_COLUMN-1;

    EPD_Init_Part();  
  
    EPD_W21_WriteCMD(0x91);   //This command makes the display enter partial mode
    EPD_W21_WriteCMD(0x90);   //resolution setting
    EPD_W21_WriteDATA (x_start);   //x-start     
    EPD_W21_WriteDATA (x_end);   //x-end  

    EPD_W21_WriteDATA (y_start/256);
    EPD_W21_WriteDATA (y_start%256);   //y-start    
    
    EPD_W21_WriteDATA (y_end/256);    
    EPD_W21_WriteDATA (y_end%256);  //y-end
    EPD_W21_WriteDATA (0x01); 
 
    if(partFlag==1) 
     {
        partFlag=0;
       
        EPD_W21_WriteCMD(0x10);        //writes Old data to SRAM for programming
        for(i=0;i<PART_COLUMN*PART_LINE/8;i++)      
           EPD_W21_WriteDATA(0xFF); 
     }
    else
     {
        EPD_W21_WriteCMD(0x10);        //writes Old data to SRAM for programming
        for(i=0;i<PART_COLUMN*PART_LINE/8;i++)      
          
          switch(j) {
            case 10: EPD_W21_WriteDATA(oldDataTIN1[i]); break;
            case 11: EPD_W21_WriteDATA(oldDataTIN2[i]); break;
            case 12: EPD_W21_WriteDATA(oldDataTIN3[i]); break;
            case 13: EPD_W21_WriteDATA(oldDataTIN4[i]); break;
            case 20: EPD_W21_WriteDATA(oldDataCO1[i]); break;
            case 21: EPD_W21_WriteDATA(oldDataCO2[i]); break;
            case 22: EPD_W21_WriteDATA(oldDataCO3[i]); break;
            case 23: EPD_W21_WriteDATA(oldDataCO4[i]); break;
            case 30: EPD_W21_WriteDATA(oldDataTOUT1[i]); break;
            case 31: EPD_W21_WriteDATA(oldDataTOUT2[i]); break;
            case 32: EPD_W21_WriteDATA(oldDataTOUT3[i]); break;
            case 33: EPD_W21_WriteDATA(oldDataTOUT4[i]); break;
            case 34: EPD_W21_WriteDATA(oldDataTOUT5[i]); break;
            case 40: EPD_W21_WriteDATA(oldDataTL1[i]); break;
            case 41: EPD_W21_WriteDATA(oldDataTL2[i]); break;
            case 42: EPD_W21_WriteDATA(oldDataTL3[i]); break;
            case 43: EPD_W21_WriteDATA(oldDataTL4[i]); break;
            default: EPD_W21_WriteDATA(oldDataP[i]); break;
          };
        
      } 
 
    EPD_W21_WriteCMD(0x13);        //writes New data to SRAM.
    for(i=0;i<PART_COLUMN*PART_LINE/8;i++)       
   {
    EPD_W21_WriteDATA(datas[i]);
    switch(j) {
      case 10: oldDataTIN1[i]=datas[i]; break;
      case 11: oldDataTIN2[i]=datas[i]; break;
      case 12: oldDataTIN3[i]=datas[i]; break;
      case 13: oldDataTIN4[i]=datas[i]; break;
      case 20: oldDataCO1[i]=datas[i]; break;
      case 21: oldDataCO2[i]=datas[i]; break;
      case 22: oldDataCO3[i]=datas[i]; break;
      case 23: oldDataCO4[i]=datas[i]; break;
      case 30: oldDataTOUT1[i]=datas[i]; break;
      case 31: oldDataTOUT2[i]=datas[i]; break;
      case 32: oldDataTOUT3[i]=datas[i]; break;
      case 33: oldDataTOUT4[i]=datas[i]; break;
      case 34: oldDataTOUT5[i]=datas[i]; break;
      case 40: oldDataTL1[i]=datas[i]; break;
      case 41: oldDataTL2[i]=datas[i]; break;
      case 42: oldDataTL3[i]=datas[i]; break;
      case 43: oldDataTL4[i]=datas[i]; break;
      default: oldDataP[i]=datas[i]; break;
    }
   }
    EPD_Update();    
    Power_off();  
    
}
////////////////////////////////////////////////////////////////////////////////////////////////////////////////////////////////////////

//Full screen partial refresh display
void EPD_Dis_PartAll(const unsigned char * datas)
{
    unsigned int i;
    EPD_Init_Part();
    //Write Data
    EPD_W21_WriteCMD(0x10);        //Transfer old data
    for(i=0;i<EPD_ARRAY;i++)    
    { 
       EPD_W21_WriteDATA(oldData[i]);  //Transfer the actual displayed data
    } 
    EPD_W21_WriteCMD(0x13);        //Transfer new data
    for(i=0;i<EPD_ARRAY;i++)       
    {
      EPD_W21_WriteDATA(datas[i]);  //Transfer the actual displayed data
       oldData[i]=datas[i]; 
    }  
      
    EPD_Update();    
    Power_off();    

}

//Partial refresh write address and data
void EPD_Dis_Part_RAM(unsigned int x_start,unsigned int y_start,
                        const unsigned char * datas_A,const unsigned char * datas_B,
                        const unsigned char * datas_C,const unsigned char * datas_D,const unsigned char * datas_E,
                        unsigned char num,unsigned int PART_COLUMN,unsigned int PART_LINE)
{
  unsigned int i,x_end,y_end;
  x_start=x_start-x_start%8;
  x_end=x_start+PART_LINE-1; 
  y_end=y_start+PART_COLUMN*num-1;

    EPD_Init_Part();  
    EPD_W21_WriteCMD(0x91);   //This command makes the display enter partial mode
    EPD_W21_WriteCMD(0x90);   //resolution setting
    EPD_W21_WriteDATA (x_start);   //x-start     
    EPD_W21_WriteDATA (x_end);   //x-end  

    EPD_W21_WriteDATA (y_start/256);
    EPD_W21_WriteDATA (y_start%256);   //y-start    
    
    EPD_W21_WriteDATA (y_end/256);    
    EPD_W21_WriteDATA (y_end%256);  //y-end
    EPD_W21_WriteDATA (0x01); 


  if(partFlag==1) 
   {
      partFlag=0;
     
      EPD_W21_WriteCMD(0x10);        //writes Old data to SRAM for programming
      for(i=0;i<PART_COLUMN*PART_LINE*num/8;i++)      
         EPD_W21_WriteDATA(0xFF); 
   }
  else
   {
      EPD_W21_WriteCMD(0x10);        //writes Old data to SRAM for programming
      for(i=0;i<PART_COLUMN*PART_LINE/8;i++)       
        EPD_W21_WriteDATA(oldDataA[i]);              
      for(i=0;i<PART_COLUMN*PART_LINE/8;i++)       
        EPD_W21_WriteDATA(oldDataB[i]);  
      for(i=0;i<PART_COLUMN*PART_LINE/8;i++)       
        EPD_W21_WriteDATA(oldDataC[i]);              
      for(i=0;i<PART_COLUMN*PART_LINE/8;i++)       
        EPD_W21_WriteDATA(oldDataD[i]);
      for(i=0;i<PART_COLUMN*PART_LINE/8;i++)       
        EPD_W21_WriteDATA(oldDataE[i]);              
   
       
    } 
 

  EPD_W21_WriteCMD(0x13);        //writes New data to SRAM.
    {
      for(i=0;i<PART_COLUMN*PART_LINE/8;i++)  
      {     
        EPD_W21_WriteDATA(datas_A[i]);  
        oldDataA[i]=datas_A[i];
      }         
      for(i=0;i<PART_COLUMN*PART_LINE/8;i++)  
      {     
        EPD_W21_WriteDATA(datas_B[i]);  
        oldDataB[i]=datas_B[i];
      } 
      for(i=0;i<PART_COLUMN*PART_LINE/8;i++)  
      {     
        EPD_W21_WriteDATA(datas_C[i]);  
        oldDataC[i]=datas_C[i];
      } 
      for(i=0;i<PART_COLUMN*PART_LINE/8;i++)  
      {     
        EPD_W21_WriteDATA(datas_D[i]);  
        oldDataD[i]=datas_D[i];
      } 
      for(i=0;i<PART_COLUMN*PART_LINE/8;i++)  
      {     
        EPD_W21_WriteDATA(datas_E[i]);  
        oldDataE[i]=datas_E[i]; 
      } 
    }
    
}
//Clock display
void EPD_Dis_Part_Time(unsigned int x_start,unsigned int y_start,
                        const unsigned char * datas_A,const unsigned char * datas_B,
                        const unsigned char * datas_C,const unsigned char * datas_D,const unsigned char * datas_E,
                        unsigned char num,unsigned int PART_COLUMN,unsigned int PART_LINE)
{
  EPD_Dis_Part_RAM(x_start,y_start,datas_A,datas_B,datas_C,datas_D,datas_E,num,PART_COLUMN,PART_LINE);
  EPD_Update();
  Power_off();  
}                        



////////////////////////////////Other newly added functions////////////////////////////////////////////
//Display rotation 180 degrees initialization
void EPD_Init_180(void)
{
  EPD_W21_RST_0;  // Module reset   
  delay(10);//At least 10ms delay 
  EPD_W21_RST_1;
  delay(10); //At least 10ms delay 
  
  EPD_W21_WriteCMD(0x00);
  EPD_W21_WriteDATA(0x1B); //180 mirror
  
  EPD_W21_WriteCMD(0x04); //POWER ON
  delay(300);  
  lcd_chkstatus();
  
  EPD_W21_WriteCMD(0X50);  //VCOM AND DATA INTERVAL SETTING     
  EPD_W21_WriteDATA(0x97); //WBmode:VBDF 17|D7 VBDW 97 VBDB 57    WBRmode:VBDF F7 VBDW 77 VBDB 37  VBDR B7  
  
}


/***********************************************************
            end file
***********************************************************/
